LiferLifer/SDM273-Lever-Weighing/assets/image-20230604205210499.png

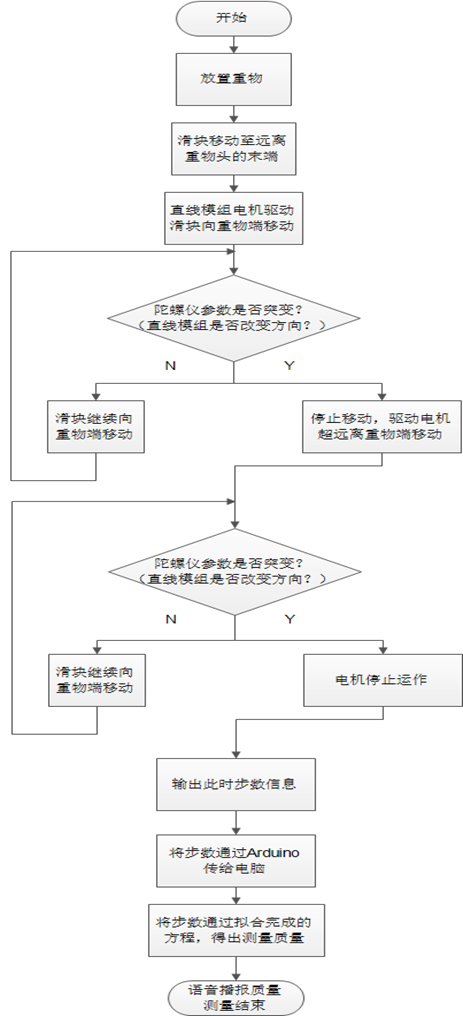
assets/image-20230604205210499.png
