LiferLifer/SDM273-Lever-Weighing/(commit log)

2023-05-20 v1.0.4
    MPU6050自动清零？
2023-05-27 v1.1.2
    更换了使用的主要传感器……
    添加了额外的计算芯片。
2023-05-27 v1.1.3
    🐱🐱
2023-06-03 v1.2.0
    现场送进120！
2023-06-04 v1.2.1
    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
2023-06-04 v1.2.1 更新了README…… 现场送进120！
